Domochip/WirelessCTSensors/schematic/WirelessCTSensors.kicad_pcb

## KiCad design schematic/WirelessCTSensors.kicad_pcb (2019-09-09)

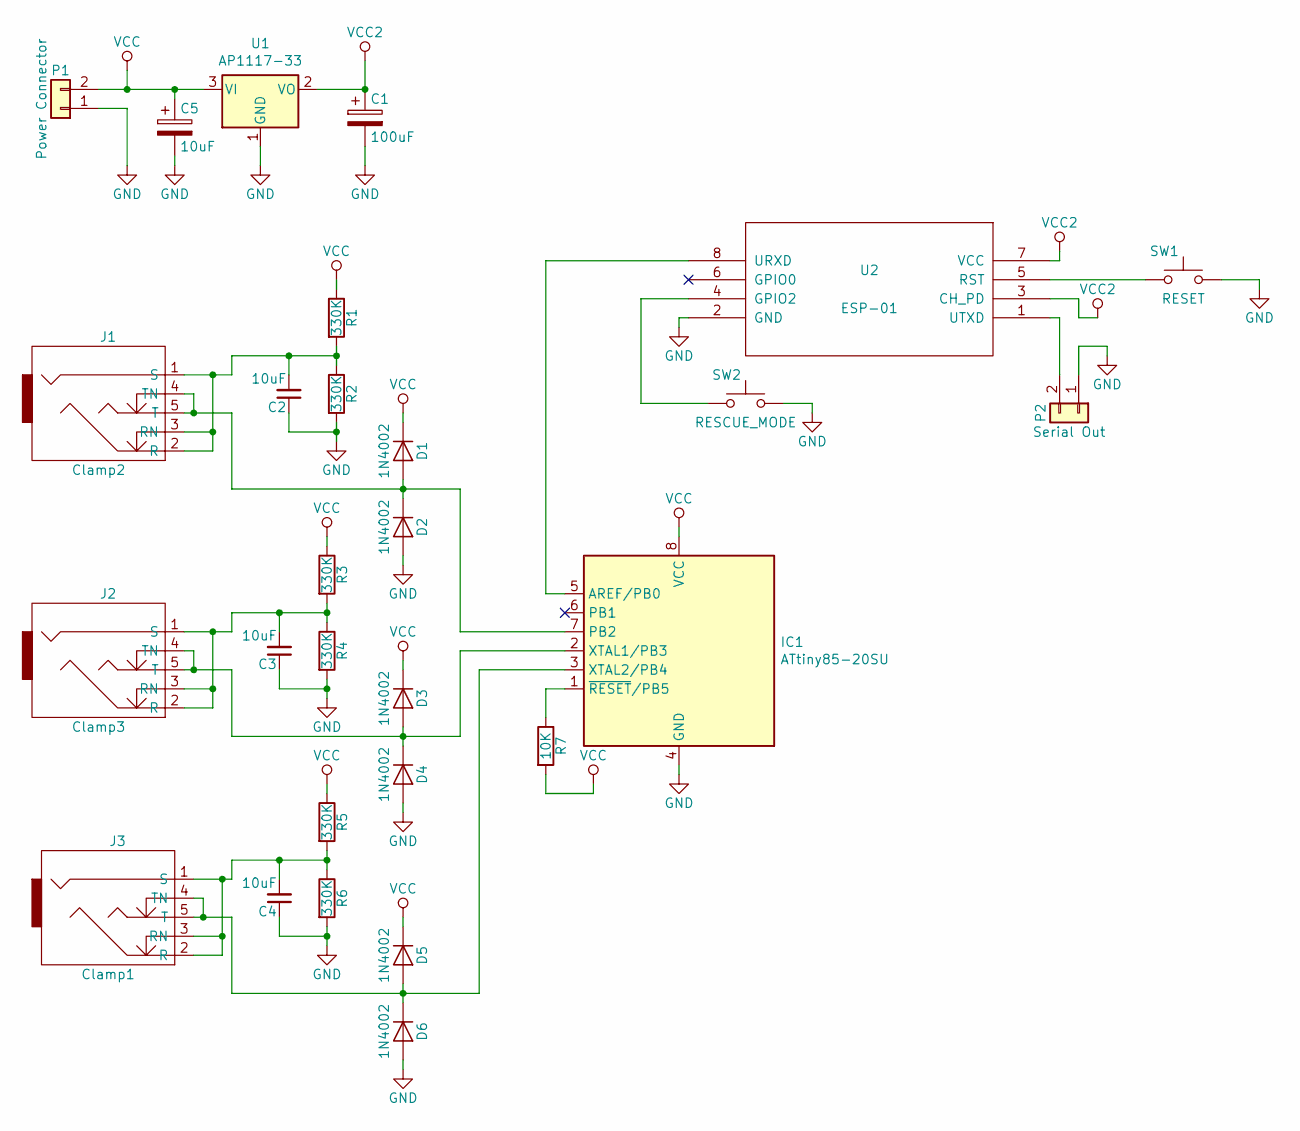
[picture p1: schematic WirelessCTSensors.sch]

Parts:
C1: 100uF; TantalC_SizeB_EIA-3528_HandSoldering
C2, C3, C4: 10uF; C_0805_HandSoldering
C5: 10uF; TantalC_SizeA_EIA-3216_HandSoldering
D1, D2, D3, D4, D5, D6: 1N4002; SMA_Handsoldering
IC1: ATtiny85-20SU; DIP-8_W7.62mm_LongPads
J1: Clamp2; jack_trs_5pins
J2: Clamp3; jack_trs_5pins
J3: Clamp1; jack_trs_5pins
P1: Power Connector; TerminalBlock_bornier-2_P5.08mm
P2: Serial Out; Pin_Header_Straight_1x02_Pitch2.54mm
R1, R2, R3, R4, R5, R6: 330K; R_0805_HandSoldering
R7: 10K; R_0805_HandSoldering
SW1: RESET; SW_PUSH_6mm
SW2: RESCUE_MODE; SW_PUSH_6mm
U1: AP1117-33; SOT-223
U2: ESP-01

Connections:
GND: C1.2, C2.1, C3.1, C4.1, C5.2, D2.2 (A), D4.2 (A), D6.2 (A), IC1.4 (GND), P1.1, P2.1, R2.2, R4.2, R6.2, SW1.2, SW2.2, U1.1 (GND), U2.2 (GND)
unnamed: C2.2, J1.1 (S), J1.2 (R), J1.3 (RN), R1.2, R2.1
unnamed: C3.2, J2.1 (S), J2.2 (R), J2.3 (RN), R3.2, R4.1
unnamed: C4.2, J3.1 (S), J3.2 (R), J3.3 (RN), R5.2, R6.1
unnamed: D1.2 (A), D2.1 (K), IC1.7 (PB2), J1.4 (TN), J1.5 (T)
unnamed: D3.2 (A), D4.1 (K), IC1.2 (XTAL1/PB3), J2.4 (TN), J2.5 (T)
unnamed: D5.2 (A), D6.1 (K), IC1.3 (XTAL2/PB4), J3.4 (TN), J3.5 (T)
unnamed: IC1.1 (~RESET~/PB5), R7.1
unnamed: IC1.5 (AREF/PB0), U2.8 (URXD)
unnamed: P2.2, U2.1 (UTXD)
unnamed: SW1.1, U2.5 (RST)
unnamed: SW2.1, U2.4 (GPIO2)
VCC: C5.1, D1.1 (K), D3.1 (K), D5.1 (K), IC1.8 (VCC), P1.2, R1.1, R3.1, R5.1, R7.2, U1.3 (VI)
VCC2: C1.1, U1.2 (VO), U2.3 (CH_PD), U2.7 (VCC)

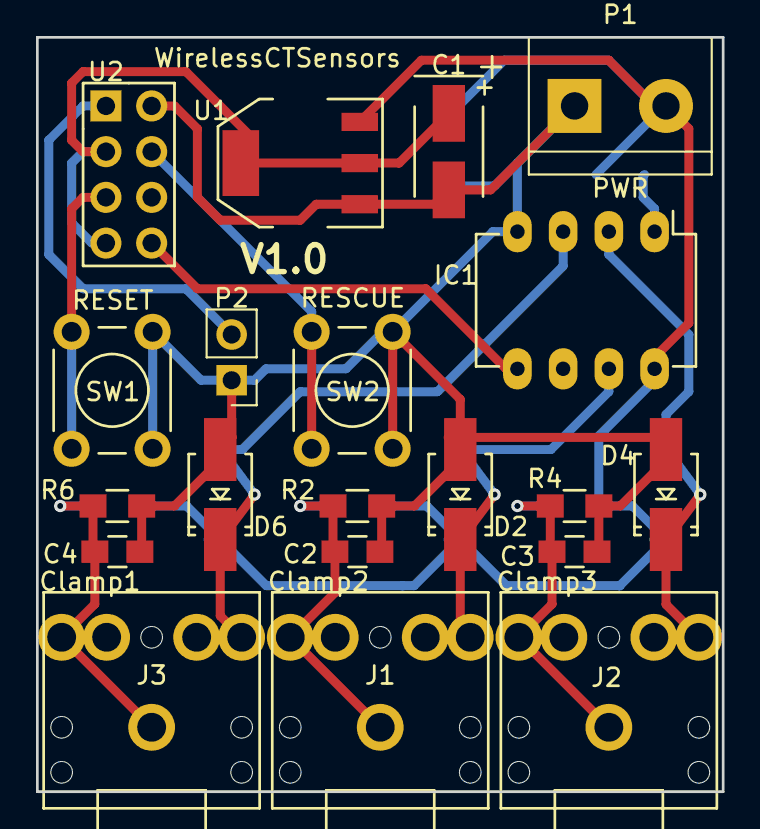
[picture p2: board WirelessCTSensors.kicad_pcb from above]

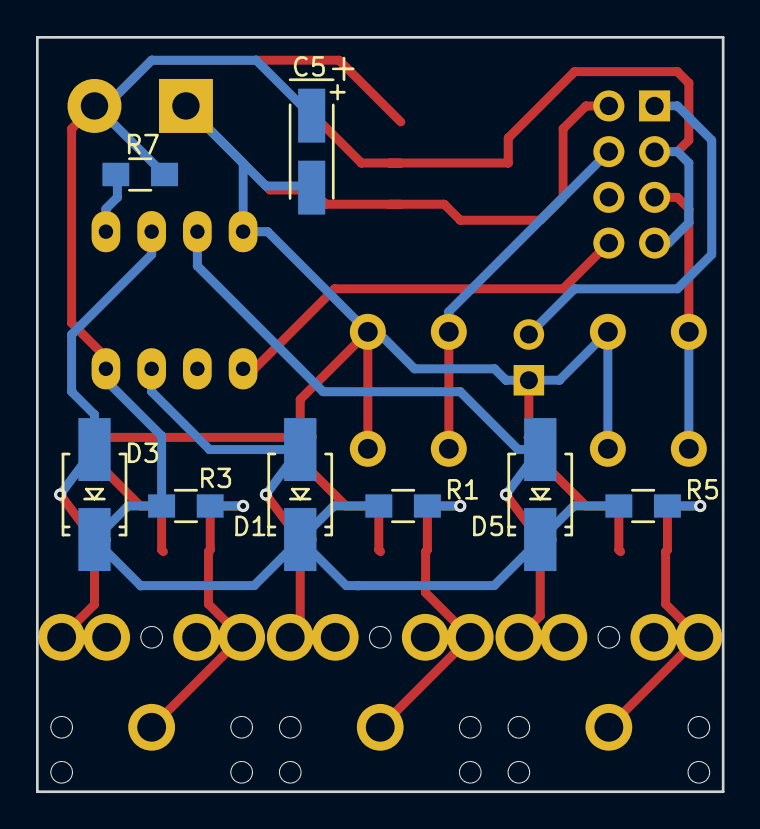
[picture p3: board WirelessCTSensors.kicad_pcb from below]

Board: 2 copper layers, 38.1 x 41.9 mm, 28 parts (8 on the bottom side), 14 nets.
