Domochip/WirelessCTSensors/(commit log)

2018-03-13 V3.1.3 Initial Commit
    [WirelessCTSensors.kicad_pcb, WirelessCTSensors.sch]
2018-03-24 Update according to Base v1.0.5 + v3.1.4
    3.1.4 add Reset Method to CTSensor for app Reinit
    [CTSensor.cpp, CTSensor.h, Main.cpp, Main.h, WirelessCTSensors.h, WirelessCTSensors.ino]
2018-05-22 Switch to PlatformIO
    [WirelessCTSensors BOM v1.0.xlsx]
2018-06-20 Switch to Base v1.0.10
2018-10-26 Switch to Base V1.1.5
2018-11-17 Switch to Base V1.1.6
    - No More PowerShell
    - GZIP and convertion to header done in python with platformIO
    - Webpages small improvement
2019-03-17 V3.1.6 Upgrade to Base V1.1.7
    [WirelessCTSensors BOM v1.0.xlsx]
2019-04-13 V3.1.7 Replace SimpleTimer by Ticker
    [Main.h, SimpleTimer.h, WirelessCTSensors.cpp, WirelessCTSensors.h]
2019-09-09 Update schematic with KiCad 5.1.4
    [WirelessCTSensors.kicad_pcb, WirelessCTSensors.sch]
2019-09-15 V3.2.0 Add MQTT / Remove HTTP Jeedom
    Due to Jeedom evolution, We can't anymore request virtual values.
    Switch to MQTT protocol using retain flag on counter to be able to get it back at reboot
    [Main.h, WirelessCTSensors.cpp, WirelessCTSensors.h]
2020-01-12 Update schematic
    [WirelessCTSensors.sch]
