Domochip/WirelessCTSensors/(notices)

Notices in the files:
CTSensorsReader/SimpleTimer.h:
General Public License as published by the Free Software
General Public License along with this library; if not,
write to the Free Software Foundation, Inc.,
51 Franklin St, Fifth Floor, Boston, MA 02110-1301 USA
